JavaJimbo/PIC32MX795_BrainBoard_EaglePCB/README.md

# PIC32MX795_BrainBoard_EaglePCB
Eagle PCB layout files for my micro controller board using the PIC32MX795F512L
