JavaJimbo/PIC32MX795_BrainBoard_EaglePCB/PIC795 Brain Board BOM.xlsx

BOM Robotnik PIC 795 Brain Board Rev 1.0
7/11/2019
Part | Value | Device | Package | Manufacturer | Mfg Part No | Digikey Part No
C1-C9,C17 | 0.1 uF | CAP-1206 | 1206 | Yageo | CC1206KKX7R0BB104 | 311-1488-1-ND
C10-C11 | 10 uF | CAP-1206 | 1206 | TDK | C3216X7R1C106K160AC | 445-4042-1-ND
C12,C13 | 22 pF | C0805 | C0805 | Kemet | C0805C220J5RAC7800‎ | 399-17625-1-ND
C14,C16 | 22 uF | Electrolytic cap | Radial can 0.079" spacing | Rubycon | 50YXM22MEFC5X11 | 1189-1872-ND
C19,C20 | 0.1 uF | Cap ceramic, thru hole | 5mm lead spacing | Vishay | K104K10X7RF5UH5 | BC2665CT-ND
D1,D2 | 40V | SB140 Schottky Rectifier | DO-41 | SMC Diode Solutions | SB140TA | 1655-1514-1-ND
J1,J2,J3,J4 | 26 pin dual row | Female socket 26 pin | CONN HDR 26POS 0.1 TIN PCB | Sullins | PPTC132LFBN-RC | S7081-ND
J5,J6,J10 | 4 pin header | Polarized ramp lock | 0.1" male header | Molex | 22232041 | WM4202-ND
J7 | USB 2.0 | CONN RCPT USB2.0 TYPEB | 4POS R/A Thru hole | Amphenol | 61729-1011BLF | 609-3657-ND
J8 | 2.10mm ID, 5.5mm OD | Power jack, RA | 3 pin thru hole | CUI | PJ-202A | CP-202A-ND
J9 | RJ11-2L-B | RJ11 programming connector | RJ11 Thu hole 6 pin | TE Connectivity | 5555165-1 | A31422-ND
J11 | 6 pin header | Polarized ramp lock | 0.1" male header | Molex | 22232061 | WM4204-ND
J12 | 3 pin header | Polarized ramp lock | 0.1" male header | Molex | 22232031 | WM4201-ND
J13 | 2 pin header | Polarized ramp lock | 0.156" male header | Molex | 0026604020 | WM4620-ND
LED1 | RED LED | Diffused 5mm | T-1 3/4 Thru hole | VCC | 4304H1 | L71532-ND
LED2 | YELLOW LED | Diffused 5mm | T-1 3/4 Thru hole | VCC | 4304H7 | 4304H7-ND
R1, R3 | 220 ohm | Resistor thru hole | 1/4_WATT | Stackpole | CF18JT220R | CF18JT220RCT-ND
R2 | 10k | 8 resistor bussed array | 10 pin SIP thru hole | Bourns | 4609X-101-103LF | 4609X-101-103LF-ND
SW1 | Pushbutton momentary SPST | 320 Series blue | Through hole | E Switch | 320.02E11.08BLU | EG2553-ND
U1 | 3.3V LDO REGULATOR | LD1086 | D2PAK | ST Micro | LD1086D2T33TR | 497-1224-1-ND
U2 | SD CARD socket | CONN SD CARD PUSH-PULL | Surface mount right angle | TE Connectivity | 2041021-4 | A101492CT-ND
U3 | PIC microcontroller | PIC32MX795F512L | TQFP-100-14X14MM | Microchip | PIC32MX795F512L-80I/PF | PIC32MX795F512L-80I/PF-ND
U4 | RS485 half duplex transceiver | MAX485 | SOICN | Maxim | MAX3430CSA+ | ‎MAX3430CSA+‎
U5 | EEPROM I2C | 24LC256 | 8 pin dip | Microchip | 24LC256-I/P | 24LC256-I/P-ND
X1 | 8 Mhz, 50 ppm | Crystal SMD | HC-49/US | ECS | ECS-80-20-5PX-TR | XC2076CT-ND
