JavaJimbo/PIC32MX795_BrainBoard_EaglePCB/PIC795 Brain Board.brd

## EAGLE design PIC795 Brain Board.brd (2019-08-12)

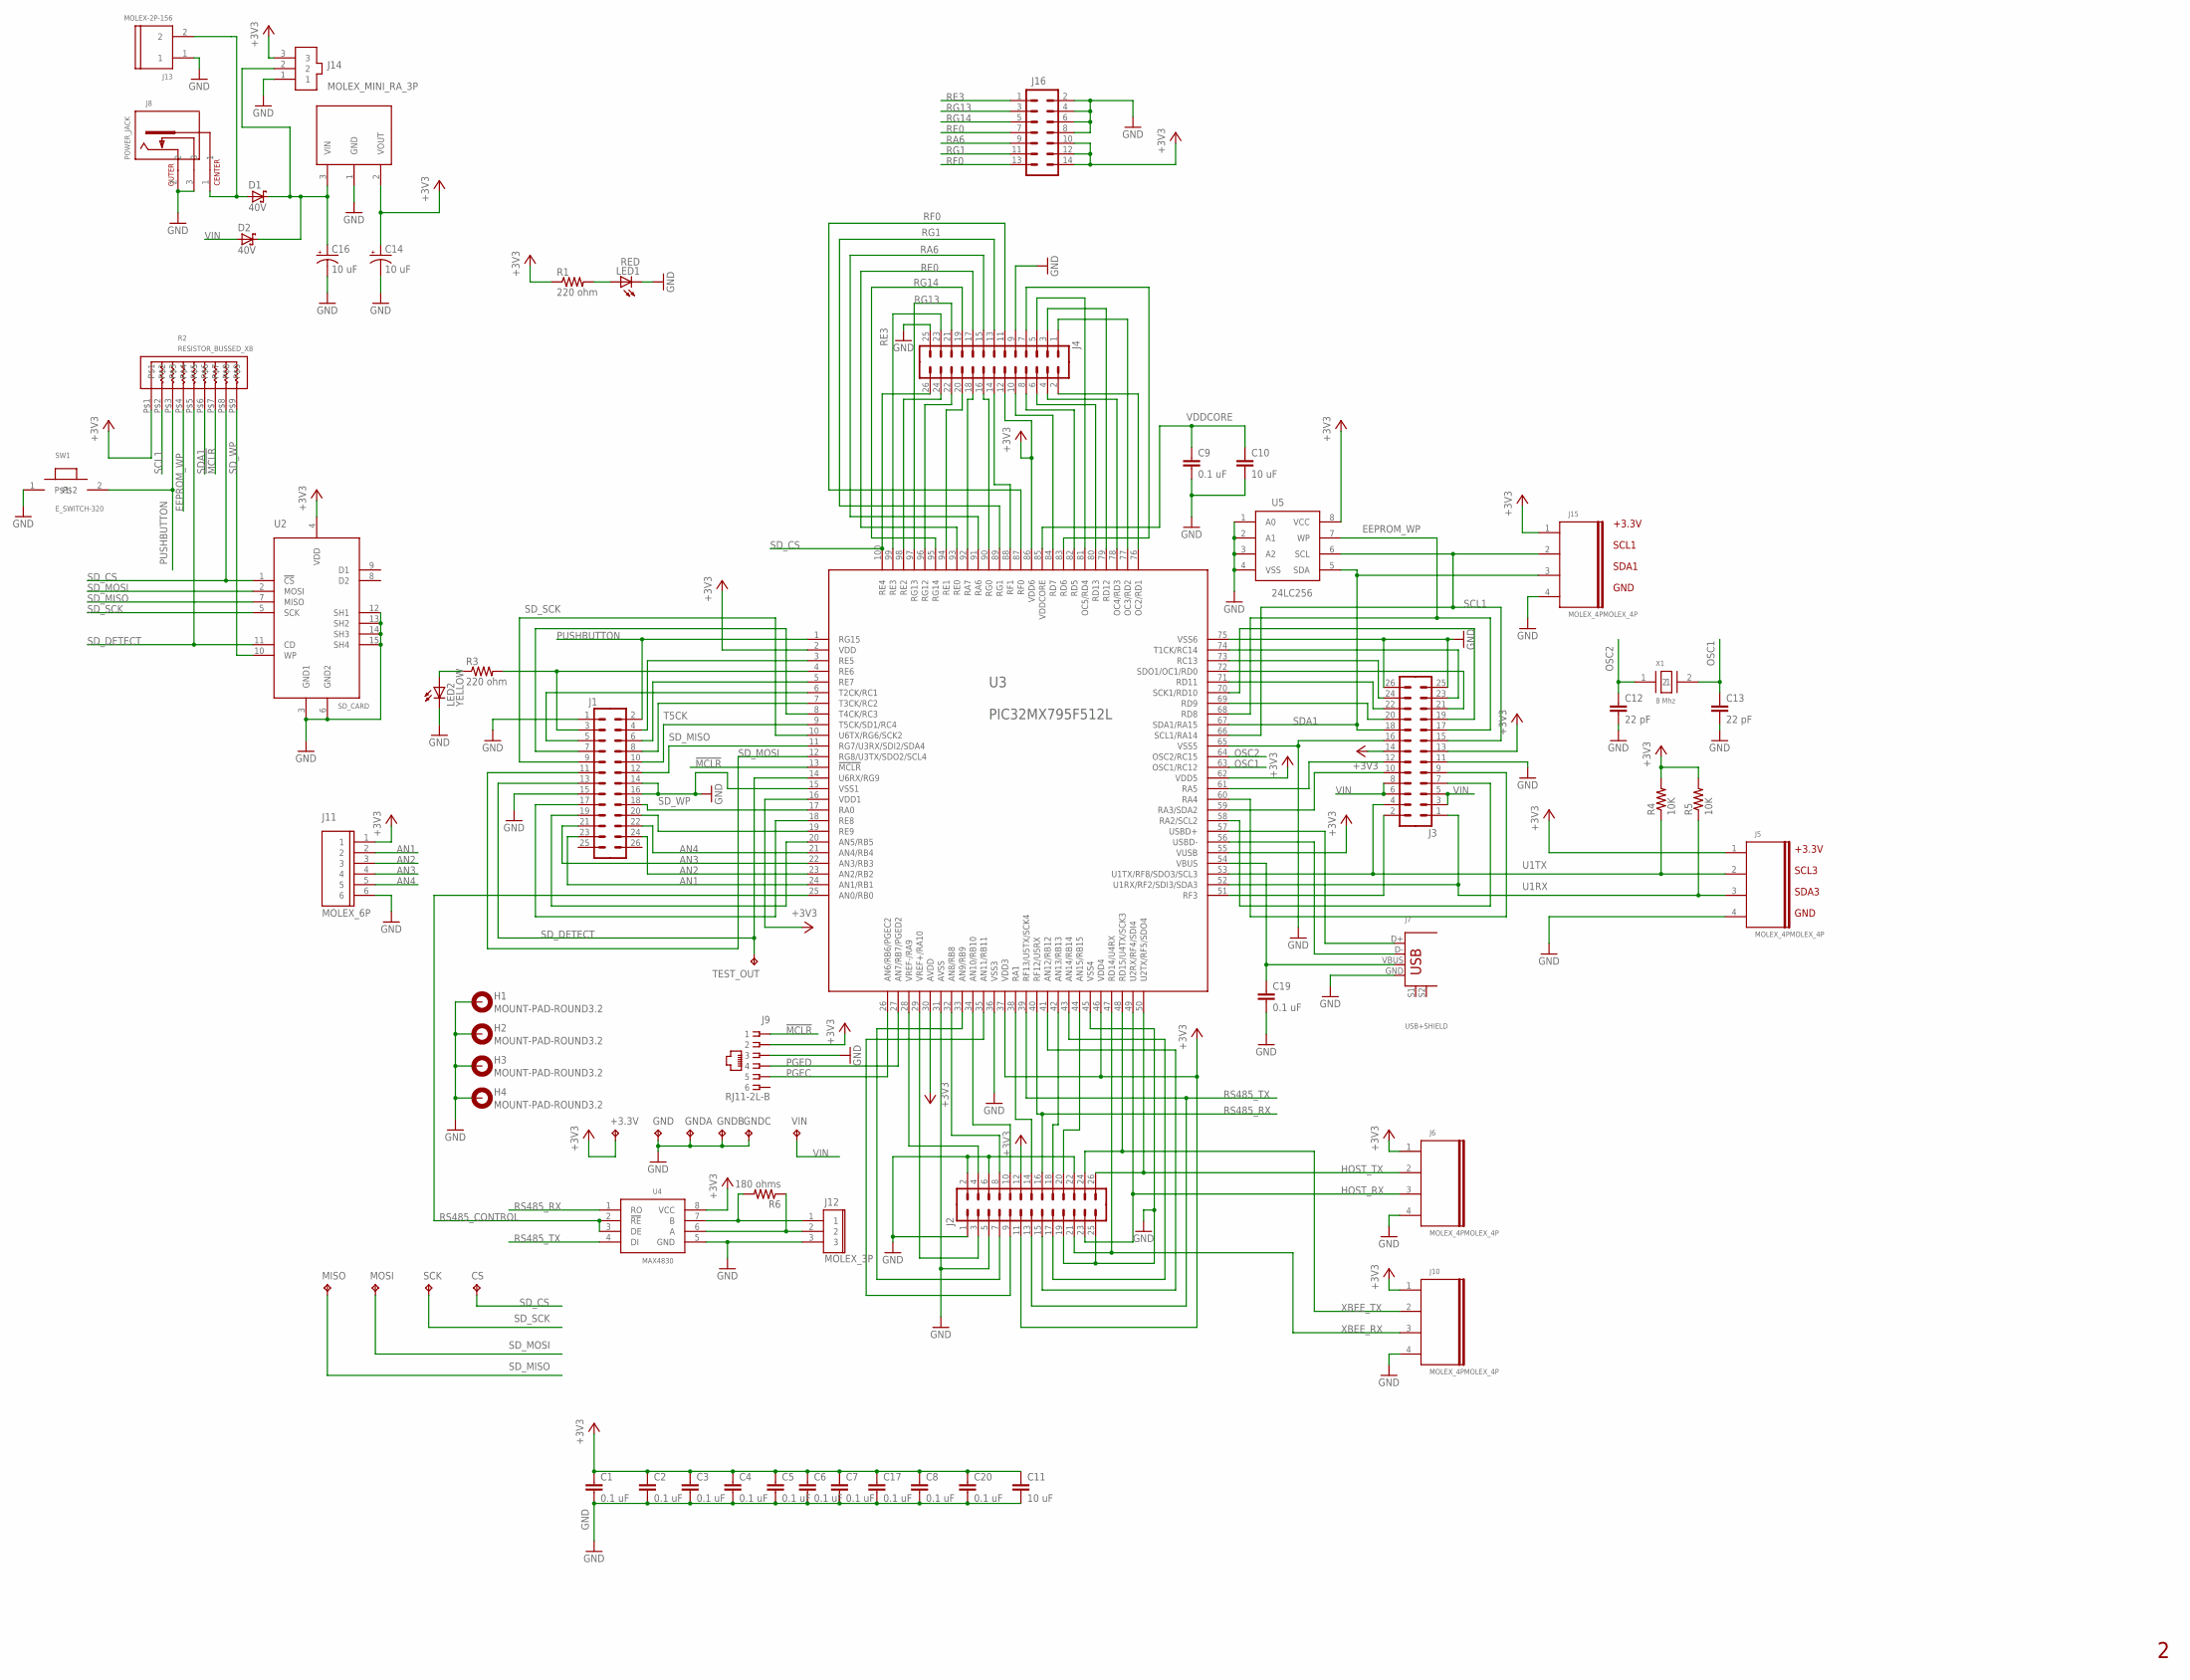
[picture p1: schematic PIC795 Brain Board.sch]

Parts:
+3.3V: TP; TESTPAD
C1, C2, C3, C4, C5, C6, C7, C8, C9, C17: 0.1 uF; 1206
C10, C11: 10 uF; 1206
C12, C13: 22 pF; C0805
C14, C16: 10 uF; E2,5-5
C19, C20: 0.1 uF; C5B2.5
CS: TP; TESTPAD
D1, D2: 40V; DO41-7.6
GND: TP; TESTPAD
GNDA: TP; TESTPAD
GNDB: TP; TESTPAD
GNDC: TP; TESTPAD
H1, H2, H3, H4: MOUNT-PAD-ROUND3.2; 3,2-PAD
J1, J2, J3, J4: M13X22X13; 2X13
J5, J6, J10, J15: MOLEX_4PMOLEX_4P; MOLEX_4P
J7: USB+SHIELD; USB-B-PTH
J8: POWER_JACK; POWER_JACK_PJ-202A
J9: RJ11-2L-B; RJ11-NO_SHIELD
J11: MOLEX_6P; MOLEX_6P_SLIM
J12: MOLEX_3P
J13: MOLEX-2P-156; MOLEX-156-2P
J14: MOLEX_MINI_RA_3P
J16: CONNECTOR_DUAL_ROW_14; 2X7
LED1: RED; LED5MM
LED2: YELLOW; LED5MM
MISO: TP; TESTPAD
MOSI: TP; TESTPAD
R1, R3: 220 ohm; 1/4_WATT
R2: RESISTOR_BUSSED_X8; RESISTOR_BUSSED
R4, R5: 10K; 1/4_WATT
R6: 180 ohms; 0204/7
SCK: TP; TESTPAD
SW1: E_SWITCH-320; E_SWITCH_320
TEST_OUT: TP; TESTPAD
U1: REGULATOR_LD1086_LDO; D2PAK
U2: SD_CARD; SD_CARD_TE_2041021
U3: PIC32MX795F512L; TQFP-100-14X14MM
U4: MAX4830; SOICN
U5: 24LC256; DIL08
VIN: TP; TESTPAD
X1: 8 Mhz; CRYSTAL-SMD

Connections:
!MCLR: J9.1, R2.P$7, U3.13 (!MCLR)
+3V3: +3.3V.P$1, C1.A (1), C2.A (1), C3.A (1), C4.A (1), C5.A (1), C6.A (1), C7.A (1), C8.A (1), C11.A (1), C14.+, C17.A (1), C20.1, J2.11, J2.12, J3.13, J3.14, J4.12, J5.1, J6.1, J9.2, J10.1, J11.1, J14.3, J15.1, J16.10, J16.12, J16.14, R1.1, R2.P$1, R4.2, R5.2, U1.2 (VOUT), U2.4 (VDD), U3.2 (VDD), U3.16 (VDD1), U3.30 (AVDD), U3.37 (VDD3), U3.46 (VDD4), U3.55 (VUSB), U3.62 (VDD5), U3.86 (VDD6), U4.8 (VCC), U5.8 (VCC)
AN1: J1.23, J11.2, U3.24 (AN1/RB1)
AN2: J1.24, J11.3, U3.23 (AN2/RB2)
AN3: J1.21, J11.4, U3.22 (AN3/RB3)
AN4: J1.22, J11.5, U3.21 (AN4/RB4)
EEPROM_WP: J3.17, R2.P$4, U3.68 (RD8), U5.7 (WP)
GND: C1.C (2), C2.C (2), C3.C (2), C4.C (2), C5.C (2), C6.C (2), C7.C (2), C8.C (2), C9.C (2), C10.C (2), C11.C (2), C12.2, C13.2, C14.-, C16.-, C17.C (2), C19.2, C20.2, GND.P$1, GNDA.P$1, GNDB.P$1, GNDC.P$1, H1.B3,2, H2.B3,2, H3.B3,2, H4.B3,2, J1.1, J1.14, J1.15, J1.16, J2.1, J2.2, J2.5, J2.6, J2.19, J2.22, J2.25, J3.11, J3.16, J3.25, J3.26, J4.9, J4.25, J5.4, J6.4, J7.GND, J8.2, J8.3, J9.3, J10.4, J11.6, J12.3, J13.1, J14.1, J15.4, J16.2, J16.4, J16.6, J16.8, LED1.K (C), LED2.K (C), SW1.1, U1.1 (GND), U2.3 (GND1), U2.6 (GND2), U2.12 (SH1), U2.13 (SH2), U2.14 (SH3), U2.15 (SH4), U3.15 (VSS1), U3.31 (AVSS), U3.36 (VSS3), U3.45 (VSS4), U3.65 (VSS5), U3.75 (VSS6), U4.5 (GND), U5.1 (A0), U5.2 (A1), U5.3 (A2), U5.4 (VSS)
HOST_RX: J2.23, J6.3, U3.49 (U2RX/RF4/SDI4)
HOST_TX: J2.26, J6.2, U3.50 (U2TX/RF5/SDO4)
unnamed: J3.2, U3.51 (RF3)
unnamed: LED2.A, R3.1
unnamed: J2.8, U3.32 (AN8/RB8)
unnamed: J7.D+, U3.57 (USBD+)
unnamed: J3.10, U3.59 (RA3/SDA2)
unnamed: J3.12, U3.61 (RA5)
unnamed: D1.A, J8.1, J13.2
unnamed: C16.+, D1.C, D2.C, J14.2, U1.3 (VIN)
unnamed: J3.20, U3.69 (RD9)
unnamed: J3.22, U3.71 (RD11)
unnamed: J3.24, U3.73 (RC13)
unnamed: C19.1, J7.VBUS, U3.54 (VBUS)
unnamed: J7.D-, U3.56 (USBD-)
unnamed: J3.7, U3.58 (RA2/SCL2)
unnamed: J3.9, U3.60 (RA4)
unnamed: J3.23, U3.74 (T1CK/RC14)
unnamed: J3.21, U3.72 (SDO1/OC1/RD0)
unnamed: J3.19, U3.70 (SCK1/RD10)
unnamed: LED1.A, R1.2
unnamed: J12.1, R6.2, U4.7 (B)
unnamed: J2.4, U3.28 (VREF-/RA9)
unnamed: J12.2, R6.1, U4.6 (A)
unnamed: J2.10, U3.34 (AN10/RB10)
unnamed: J2.14, U3.38 (RA1)
unnamed: J2.18, U3.42 (AN13/RB13)
unnamed: J2.20, U3.44 (AN15/RB15)
unnamed: J2.3, U3.29 (VREF+/RA10)
unnamed: J2.7, U3.33 (AN9/RB9)
unnamed: J2.9, U3.35 (AN11/RB11)
unnamed: J2.17, U3.43 (AN14/RB14)
unnamed: J2.15, U3.41 (AN12/RB12)
unnamed: J4.2, U3.76 (OC2/RD1)
unnamed: J4.4, U3.78 (OC4/RD3)
unnamed: J4.6, U3.80 (RD13)
unnamed: J4.8, U3.82 (RD5)
unnamed: J4.10, U3.84 (RD7)
unnamed: J4.14, U3.88 (RF1)
unnamed: J4.16, U3.90 (RG0)
unnamed: J4.18, U3.92 (RA7)
unnamed: J4.20, U3.94 (RE1)
unnamed: J4.22, U3.96 (RG12)
unnamed: J4.24, U3.98 (RE2)
unnamed: J4.1, U3.77 (OC3/RD2)
unnamed: J4.3, U3.79 (RD12)
unnamed: J4.5, U3.81 (OC5/RD4)
unnamed: J4.7, U3.83 (RD6)
unnamed: J1.4, U3.3 (RE5)
unnamed: J1.6, U3.5 (RE7)
unnamed: J1.8, U3.7 (T3CK/RC2)
unnamed: J1.20, U3.19 (RE9)
unnamed: J1.3, R3.2, U3.4 (RE6)
unnamed: J1.5, U3.6 (T2CK/RC1)
unnamed: J1.7, U3.8 (T4CK/RC3)
unnamed: J1.19, U3.20 (AN5/RB5)
unnamed: J1.17, U3.18 (RE8)
OSC1: C13.1, U3.63 (OSC1/RC12), X1.2
OSC2: C12.1, U3.64 (OSC2/RC15), X1.1
PGEC: J9.5, U3.26 (AN6/RB6/PGEC2)
PGED: J9.4, U3.27 (AN7/RB7/PGED2)
PUSHBUTTON: J1.2, R2.P$3, SW1.2, U3.1 (RG15)
RA6: J4.15, J16.9, U3.91 (RA6)
RE0: J4.17, J16.7, U3.93 (RE0)
RE3: J4.23, J16.1, U3.99 (RE3)
RF0: J4.11, J16.13, U3.87 (RF0)
RG1: J4.13, J16.11, U3.89 (RG1)
RG13: J4.21, J16.3, U3.97 (RG13)
RG14: J4.19, J16.5, U3.95 (RG14)
RS485_CONTROL: U3.25 (AN0/RB0), U4.2 (!RE), U4.3 (DE)
RS485_RX: J2.16, U3.40 (RF12/U5RX), U4.1 (RO)
RS485_TX: J2.13, U3.39 (RF13/U5TX/SCK4), U4.4 (DI)
SCL1: J3.15, J15.2, R2.P$2, U3.66 (SCL1/RA14), U5.6 (SCL)
SDA1: J3.18, J15.3, R2.P$6, U3.67 (SDA1/RA15), U5.5 (SDA)
SD_CS: CS.P$1, J4.26, R2.P$8, U2.1 (!CS), U3.100 (RE4)
SD_DETECT: J1.13, R2.P$5, TEST_OUT.P$1, U2.11 (CD), U3.14 (U6RX/RG9)
SD_MISO: J1.12, MISO.P$1, U2.7 (MISO), U3.11 (RG7/U3RX/SDI2/SDA4)
SD_MOSI: J1.11, MOSI.P$1, U2.2 (MOSI), U3.12 (RG8/U3TX/SDO2/SCL4)
SD_SCK: J1.9, SCK.P$1, U2.5 (SCK), U3.10 (U6TX/RG6/SCK2)
SD_WP: J1.18, R2.P$9, U2.10 (WP), U3.17 (RA0)
T5CK: J1.10, U3.9 (T5CK/SD1/RC4)
U1RX: J3.1, J5.3, R5.1, U3.52 (U1RX/RF2/SDI3/SDA3)
U1TX: J3.4, J5.2, R4.1, U3.53 (U1TX/RF8/SDO3/SCL3)
VDDCORE: C9.A (1), C10.A (1), U3.85 (VDDCORE)
VIN: D2.A, J3.3, J3.5, J3.6, J3.8, VIN.P$1
XBEE_RX: J2.21, J10.3, U3.47 (RD14/U4RX)
XBEE_TX: J2.24, J10.2, U3.48 (RD15/U4TX/SCK3)

Notes on the sheet:
SCL3
SDA3
GND
+3.3V
SCL1
SDA1

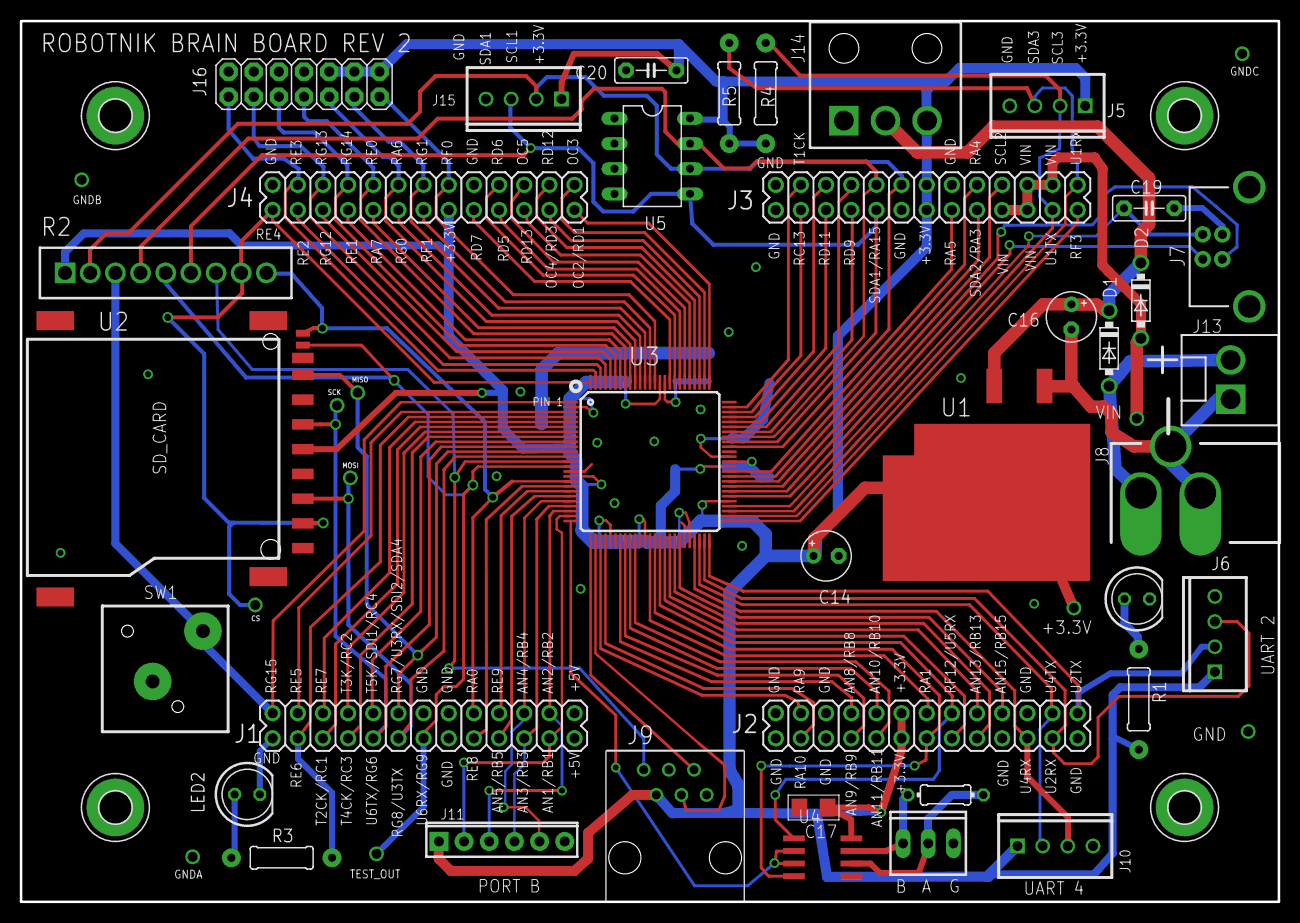
[picture p2: board PIC795 Brain Board.brd from above]

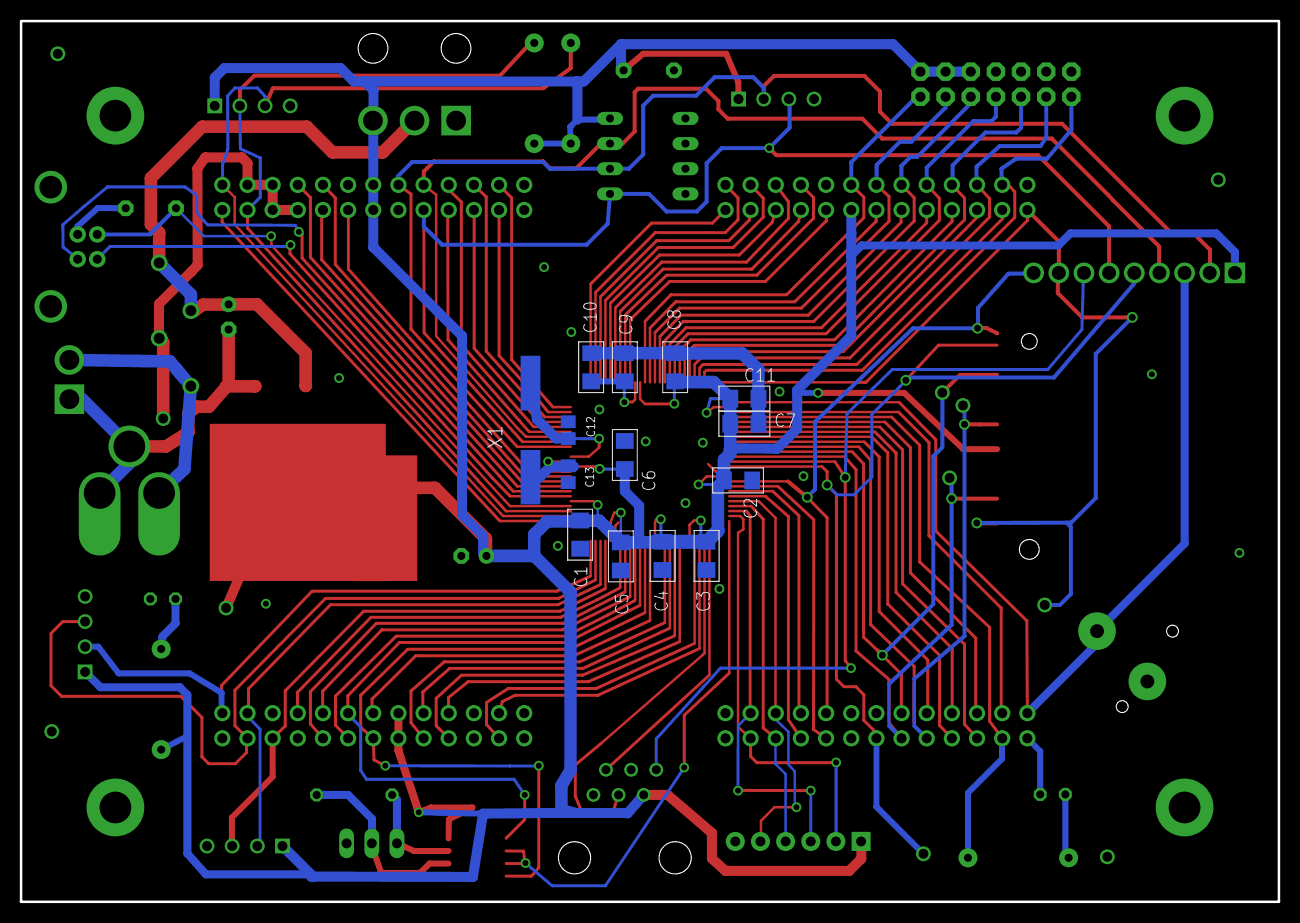
[picture p3: board PIC795 Brain Board.brd from below]

Board: 2 copper layers, 127.0 x 88.9 mm, 66 parts (14 on the bottom side), 95 nets.
