JavaJimbo/PIC32MX795_BrainBoard_EaglePCB/(commit log)

2019-07-10 Add files via upload
    First version, untested with four dual row headers, based on SnadPIC and UBW32 boards
    [PIC795 Brain Board.brd, PIC795 Brain Board.sch]
2019-07-11 Add files via upload
    Added BOM with DigiKey part numbers for first build 7/11/19
    [PIC795 Brain Board BOM.xlsx]
2019-07-21 Add files via upload
    Minor changes for Rev 2
    [PIC795 Brain Board.brd, PIC795 Brain Board.sch]
2019-08-12 Add files via upload
    Includes latest changes for Rev 2. Shipped to PCB fab 8-12-19
    [PIC795 Brain Board.brd, PIC795 Brain Board.sch]
